haunma/fieldmill/hardware/fsorx/photodiode.jpg

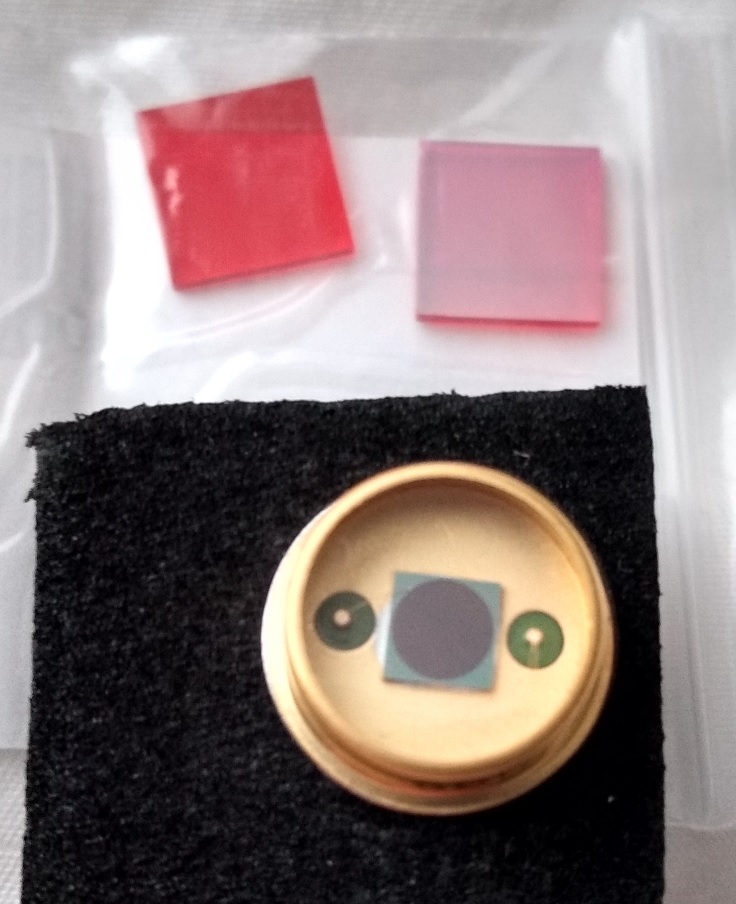
hardware/fsorx/photodiode.jpg
