haunma/fieldmill/hardware/fsorx/integrate_dump.png

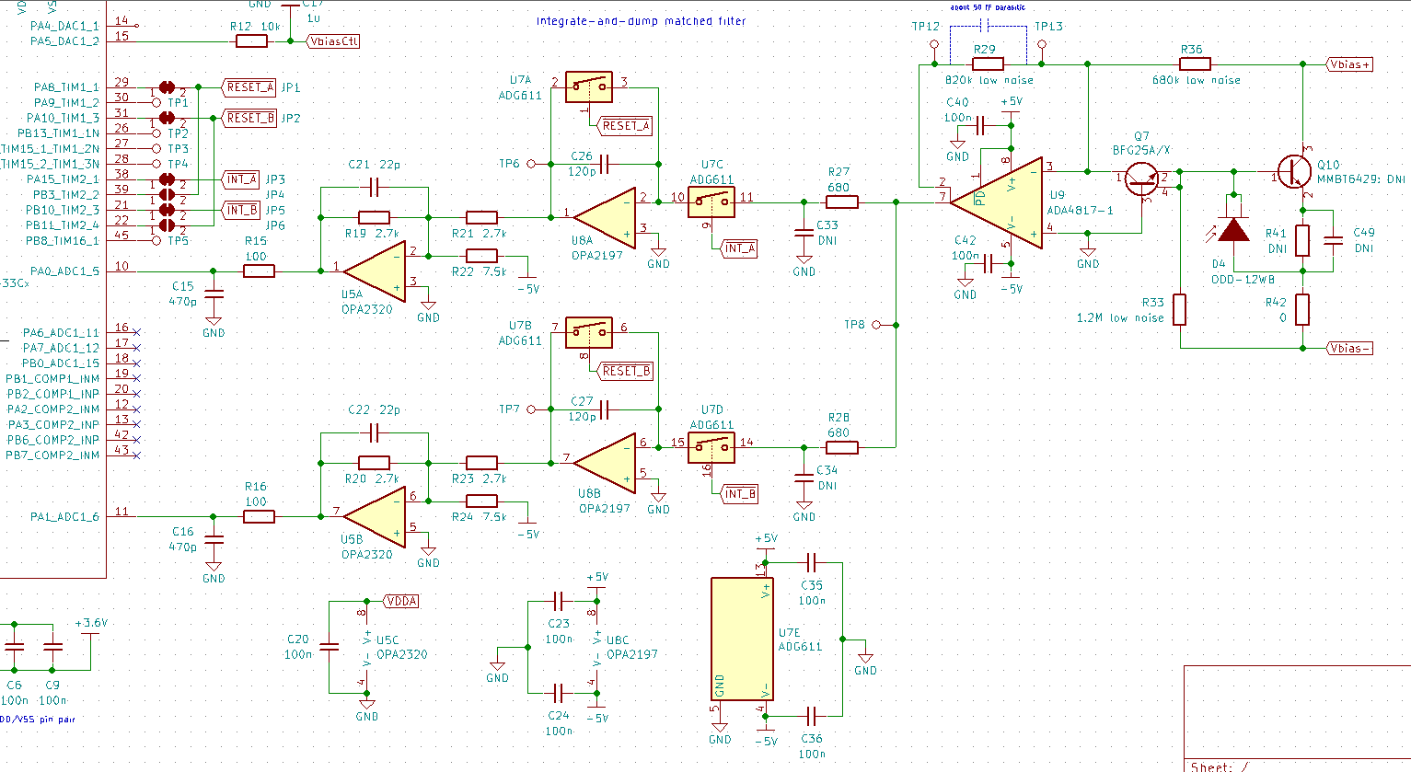
hardware/fsorx/integrate_dump.png
