haunma/fieldmill/hardware/fsorx/photodiode.png

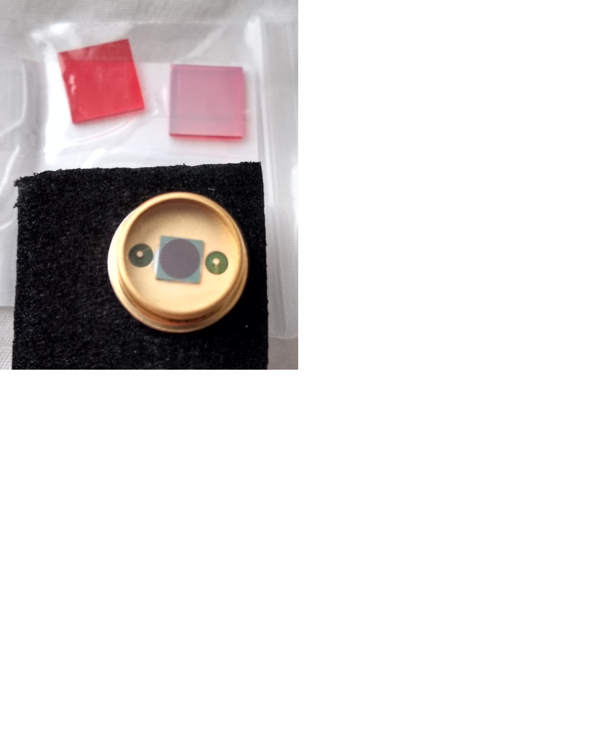
hardware/fsorx/photodiode.png
