haunma/fieldmill/hardware/fieldmill/fieldmill.pdf

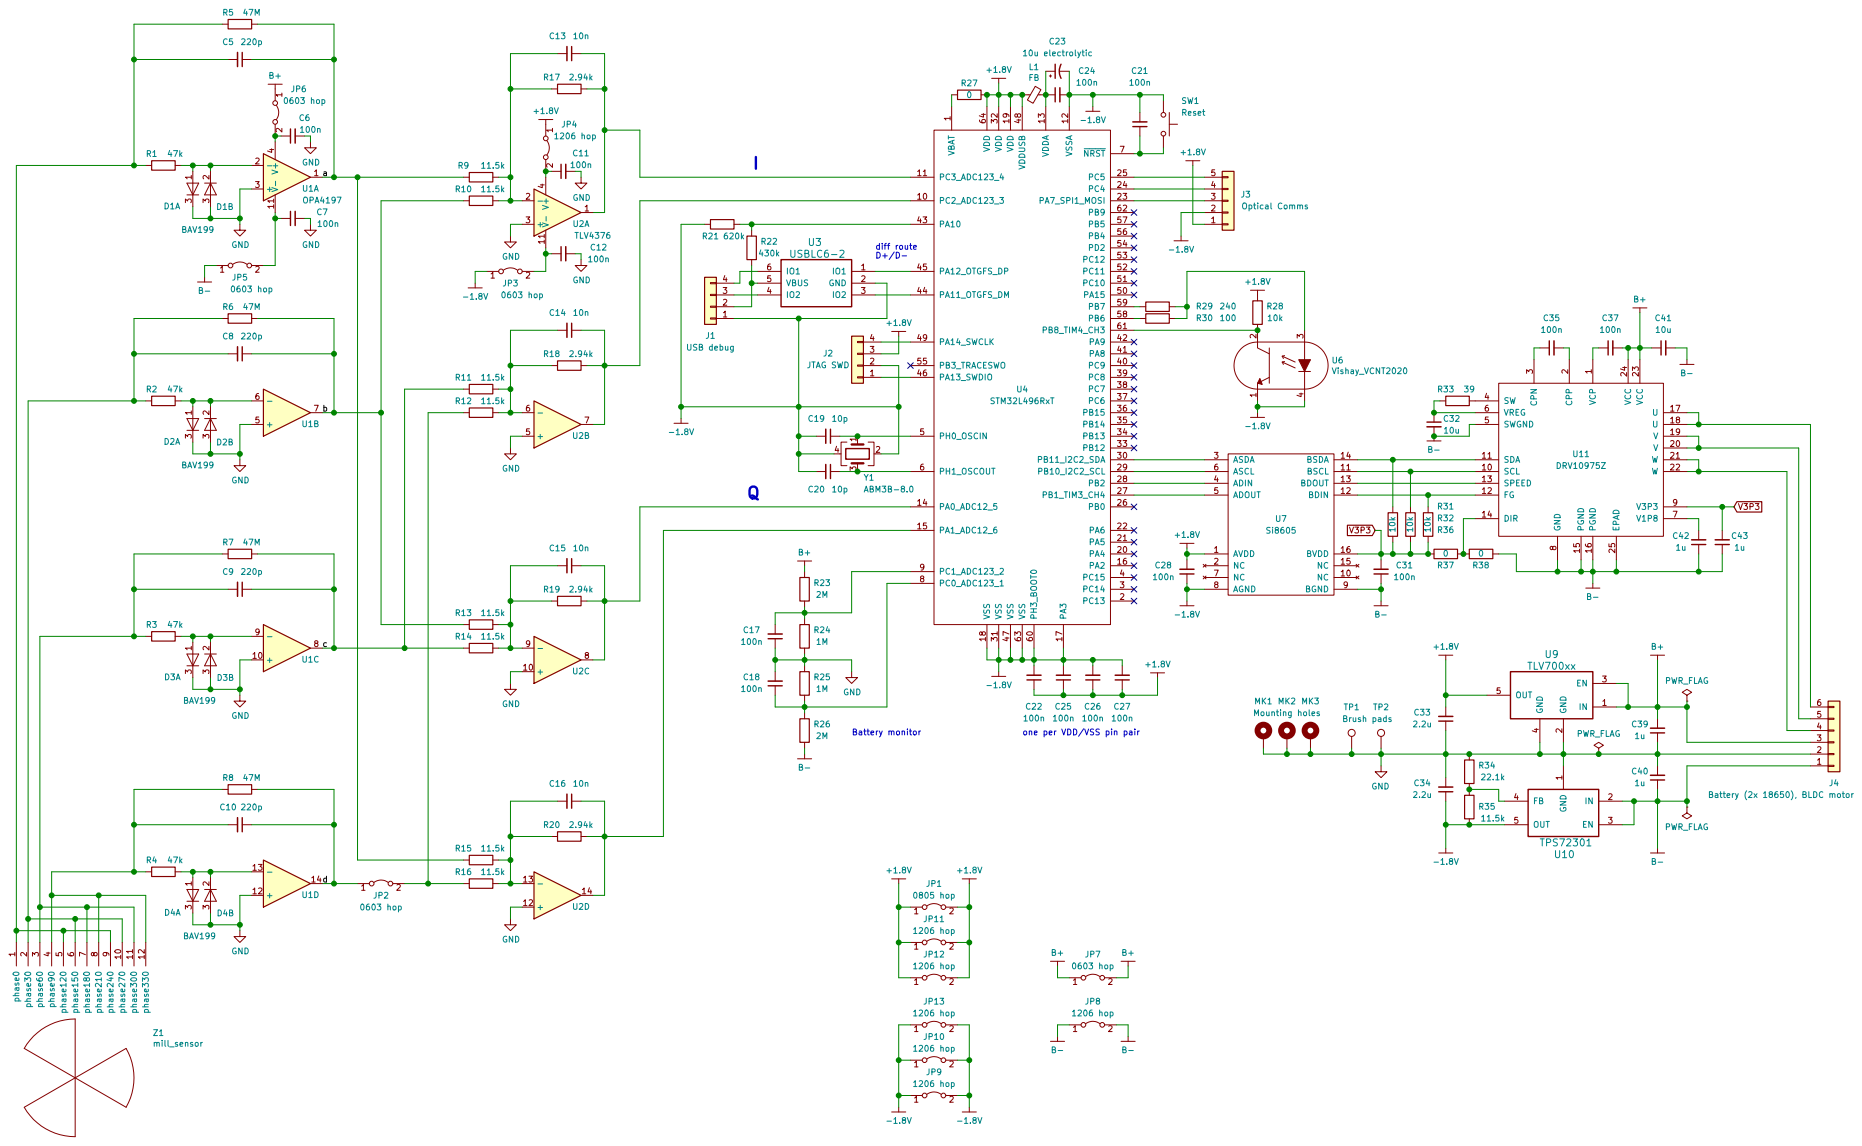
[picture p4: page 1]

1 PC2_ADC123_3 10 PC3_ADC123_4 11 VSSA 12 VDDA 13 PA0_ADC12_5 14 PA1_ADC12_6 15 PA2 16 PA3 17 VSS 18 VDD 19 PC13 2 PA4 20 PA5 21 PA6 22 PA7_SPI1_MOSI 23 PC4 24 PC5 25 PB0 26 PB1_TIM3_CH4 27 PB2 28 PB10_I2C2_SCL 29 PC14 3 PB11_I2C2_SDA 30 VSS 31 VDD 32 PB12 33 PB13 34 PB14 35 PB15 36 PC6 37 PC7 38 PC8 39 PC15 4 PC9 40 PA8 41 PA9 42 PA10 43 PA11_OTGFS_DM 44 PA12_OTGFS_DP 45 PA13_SWDIO 46 VSS 47 VDDUSB 48 PA14_SWCLK 49 PH0_OSCIN 5 PA15 50 PC10 51 PC11 52 PC12 53 PD2 54 PB3_TRACESWO 55 PB4 56 PB5 57 PB6 58 PB7 59 PH1_OSCOUT 6 PH3_BOOT0 60 PB8_TIM4_CH3 61 PB9 62 VSS 63 VDD 64 NRST 7 PC0_ADC123_1 8 PC1_ADC123_2 9 U4 STM32L496RxT

IO2 4 VBUS 5

22 VCC 23 VCC 24 EPAD 25 CPN

1 SCL 10 SDA 11 FG 12 SPEED 13 DIR 14 PGND 15 PGND 16 U
