haunma/fieldmill/hardware/fsorx/fsorx.pdf

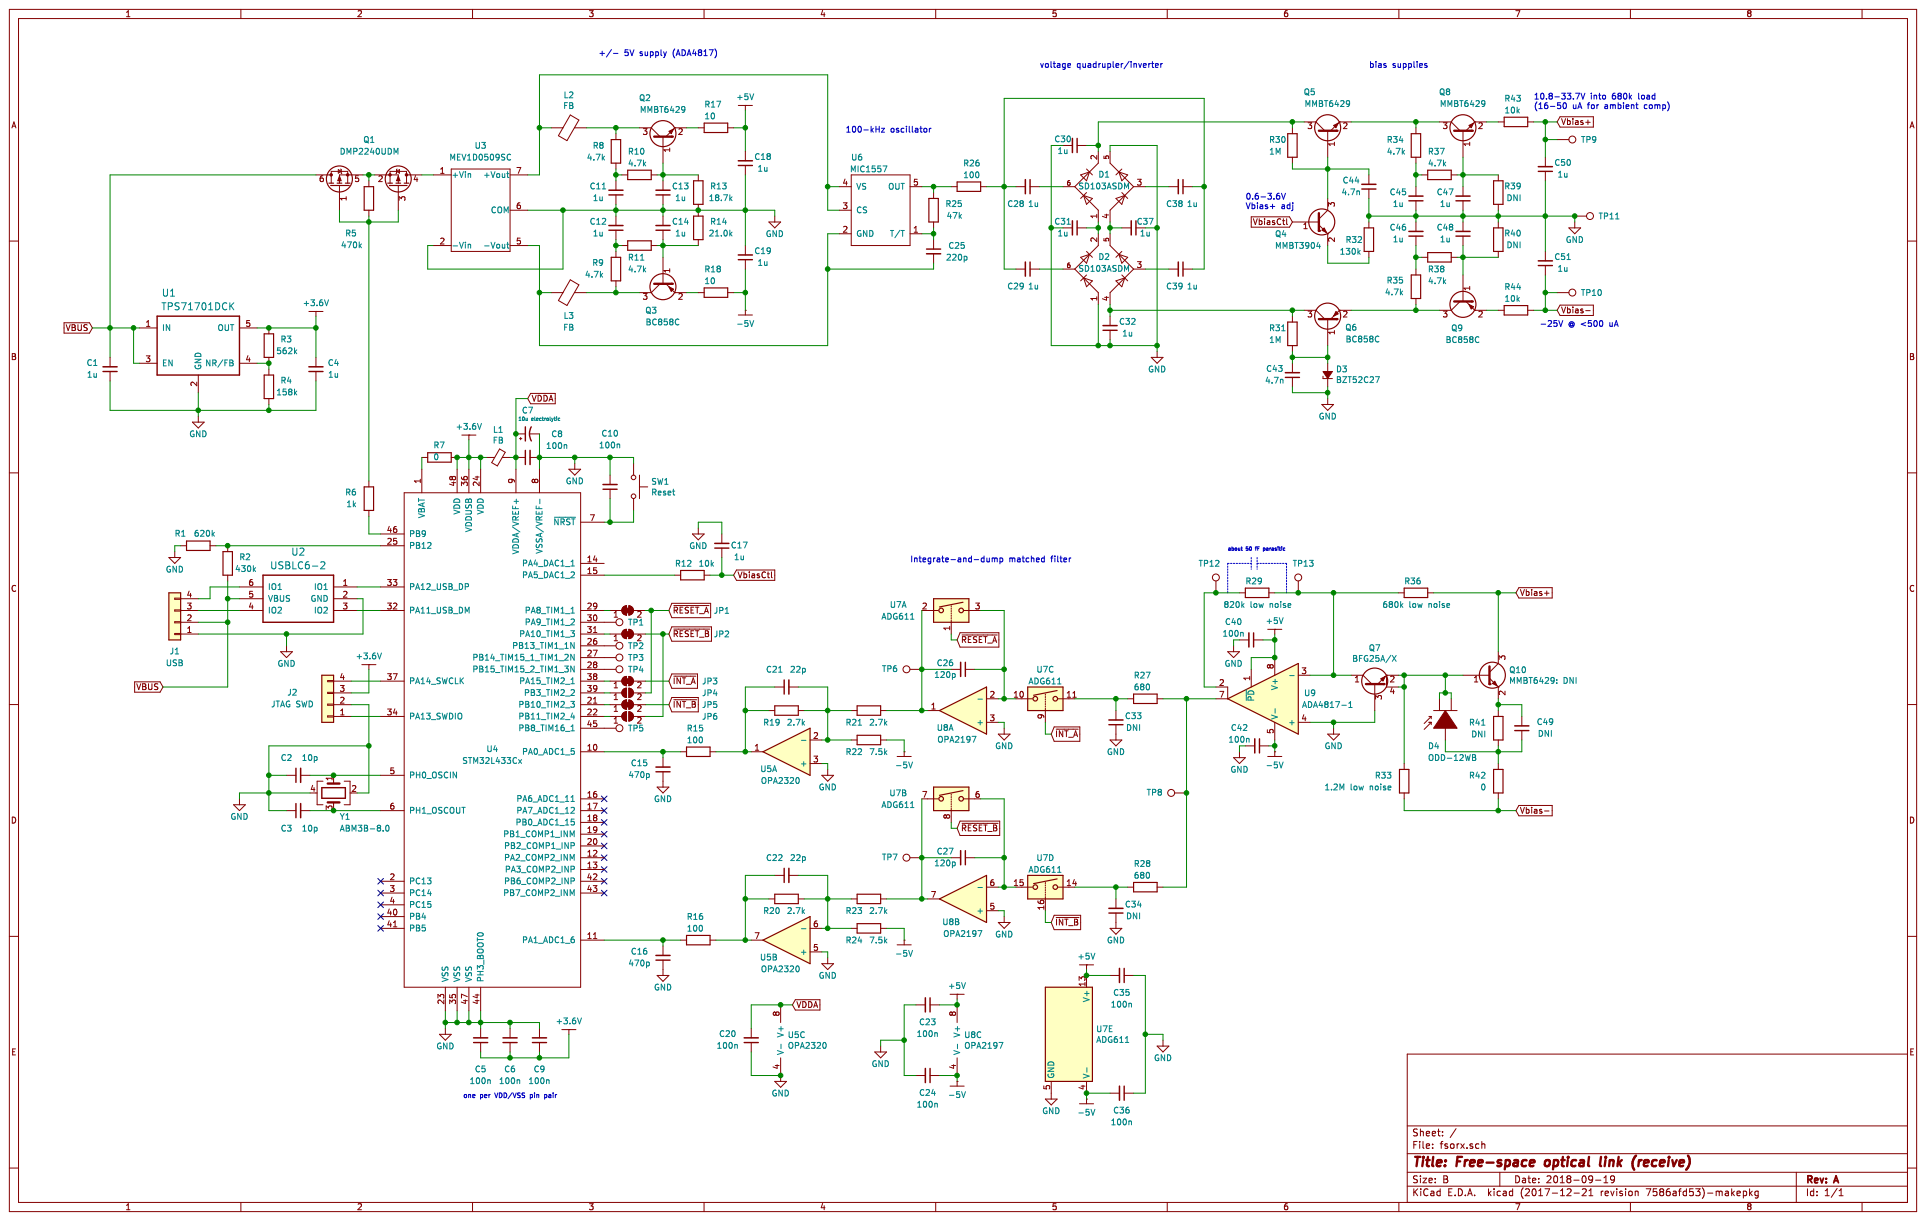
[picture p5: page 1]
