haunma/fieldmill/hardware/bias_gen.asc

C1: cap; 1µ; Rser=1 Lser=20n IC=16
C2: cap; 1µ; Rser=1 Lser=20n IC=32
C3: cap; 1µ; Rser=1 Lser=20n IC=-16
C4: cap; 1µ; Rser=1 Lser=20n IC=-32
C5: cap; 1µ; Rser=1 Lser=20n IC=-16
C6: cap; 1µ; Rser=1 Lser=20n IC=-32
C7: cap; 1µ; Rser=1 Lser=20n IC=16
C8: cap; 1µ; Rser=1 Lser=20n IC=32
C9: cap; 1µ; Rser=1 Lser=20n IC=10
C10: cap; 1µ; Rser=1
C11: cap; 1µ; Rser=1 IC=10
C12: cap; 4.7n; Rser=0.1 IC=10
C13: cap; 1µ; Rser=1 Lser=20n IC=10
C14: cap; 1µ; Rser=1 Lser=20n IC=-25
C15: cap; 1µ; Rser=1 Lser=20n IC=-25
C16: cap; 1µ; Rser=1 IC=-24
C17: cap; 4.7n; Rser=0.1 IC=-26
C18: cap; 1n; Rser=0.1 Lser=200p
C19: cap; 1n; Rser=0.1 Lser=200p
D1: schottky; BAT54
D2: schottky; BAT54
D3: schottky; BAT54
D4: schottky; BAT54
D5: schottky; BAT54
D6: schottky; BAT54
D7: schottky; BAT54
D8: schottky; BAT54
D9: zener; EDZV27B
L1: FerriteBead; 19µ; Ipk=3 Rser=0.6 Rpar=1130 Cpar=457f
L2: FerriteBead; 19µ; Ipk=3 Rser=0.6 Rpar=1130 Cpar=457f
L3: FerriteBead; 19µ; Ipk=3 Rser=0.6 Rpar=1130 Cpar=457f
L4: FerriteBead; 19µ; Ipk=3 Rser=0.6 Rpar=1130 Cpar=457f
Q1: npn; MMBT6429LT1
Q2: npn; 2N3904
Q3: npn; MMBT6429LT1
Q4: pnp; BC858C
Q5: pnp; BC858C
R2: res; 4.7k
R4: res; 4.7k
R5: res; 100k
R6: res; 10k
R7: res; 680k
R8: res; 1Meg
R9: res; 10k
R10: res; 4.7k
R11: res; 4.7k
R12: res; 10k
R13: res; 200k
R14: res; 1Meg
V1: voltage; PULSE(-9 9 0 10n 10n 7.5u 15u); Rser=15
V2: voltage; 3.5
Named nets: 0, Vp, Vn
.tran 0 400m 350m
