haunma/fieldmill/hardware/bias_gen_parasitics.asc

C1: cap; 1µ; Rser=1 Lser=20n
C2: cap; 1µ; Rser=1 Lser=20n
C3: cap; 1µ; Rser=1 Lser=20n
C4: cap; 1µ; Rser=1 Lser=20n
C5: cap; 1µ; Rser=1 Lser=20n
C6: cap; 1µ; Rser=1 Lser=20n
C7: cap; 1µ; Rser=1 Lser=20n
C8: cap; 1µ; Rser=1 Lser=20n
C9: cap; 1µ; Rser=1 Lser=20n
C10: cap; 1µ; Rser=1 Lser=20n
C11: cap; 1µ; Rser=1
C12: cap; 4.7n; Rser=0.1 Lser=10n
C13: cap; 1µ; Rser=1 Lser=20n
C14: cap; 1µ; Rser=1 Lser=20n
C15: cap; 1µ; Rser=1 Lser=20n
C16: cap; 1µ; Rser=1
C17: cap; 4.7n; Rser=0.1 Lser=10n
D1: schottky; BAT54
D2: schottky; BAT54
D3: schottky; BAT54
D4: schottky; BAT54
D5: schottky; BAT54
D6: schottky; BAT54
D7: schottky; BAT54
D8: schottky; BAT54
D9: zener; EDZV27B
L1: ind; 100µ
Q1: npn; MMBT6429LT1
Q2: npn; 2N3904
Q3: npn; MMBT6429LT1
Q4: pnp; BC858C
Q5: pnp; BC858C
R1: res; 220
R2: res; 4.7k
R4: res; 4.7k
R5: res; 130k
R6: res; 10k
R7: res; 680k
R8: res; 1Meg
R9: res; 10k
R10: res; 4.7k
R11: res; 4.7k
R12: res; 10k
R13: res; 200k
R14: res; 1Meg
V1: voltage; PULSE(-9 9 0 10n 10n 5u 10u)
V2: voltage; 0.6
Named nets: 0, Vp, Vn
.tran 0 300m 290m
