haunma/fieldmill/hardware/cmult.asc

C1: cap; 1µ
C2: cap; 1µ
C3: cap; 1µ
C4: cap; 1µ
C5: cap; 1µ
C6: cap; 1µ
I1: current; 22.3m
I2: current; 23.3m
L1: FerriteBead; 3.42µ; Ipk=0.2 Rser=0.6 Rpar=2780 Cpar=970f mfg="Würth Elektronik" pn="742 792 093"
L2: FerriteBead; 3.42µ; Ipk=0.2 Rser=0.6 Rpar=2780 Cpar=970f mfg="Würth Elektronik" pn="742 792 093"
Q1: npn; MMBT6429LT1
Q2: pnp; BC858C
R1: res; 4.7k
R2: res; 4.7k
R3: res; 10
R4: res; 4.7k
R5: res; 4.7k
R6: res; 10
R7: res; 200
R8: res; 200
R9: res; 18.7k
R10: res; 21.5k
V1: voltage; 9; AC 1; Rser=1
V2: voltage; 9; AC 1; Rser=1
Named nets: 0
.ac dec 1000 10 100Meg
