haunma/fieldmill/hardware/xtal_filt.asc

C1: cap; 2.3f
C2: cap; 0.85p
C3: cap; 0.25p
C4: cap; 0.25p
C5: cap; 0
I1: current; 0; AC 1n
L1: ind; 10.4k
Q1: npn; 2N2222
R1: res; 33k
R2: res; 100k
R3: res; 1Meg
R4: res; 100k
V1: voltage; 5
V2: voltage; 5
V3: voltage; 10
Named nets: Vp, Vm, 0
.ac lin 10000 32.4e3 32.7e3
;noise V(n001) I1 dec 1000 10 1e6
