haunma/fieldmill/hardware/xtal_osc.asc

A1: inv; td=10n Vhigh=3.3
C1: cap; 2.3f
C2: cap; 0.85p
C3: cap; 0.25p
C4: cap; 0.25p
C6: cap; 22p
C7: cap; 22p
L1: ind; 10.4k
R1: res; 33k
R5: res; 10Meg
R6: res; 300k
Named nets: 0
.tran 2m
