haunma/fieldmill/hardware/fsorx/gated_int.asc

B1: bv; V=(100u +200u*white(8e6*time))
C1: cap; 120p
C2: cap; 68p
C3: cap; 10p
C4: cap; 470p
R1: res; 680
R2: res; 0
R3: res; 0
R4: res; 2.94k
R5: res; 8.2k
R6: res; 2.94k
R7: res; 100
S1: sw; SW1
S2: sw; SW2
U1: AD8034
U2: ADA4891
V1: voltage; PULSE(1 0 0 1n 1n 1u 2u)
V2: voltage; PULSE(1 0 0.95u 1n 1n 1.7u 2u)
V3: voltage; 5
V4: voltage; 5
V5: voltage; 3.6
Named nets: 0, int, reset, out, Vp, Vm, Va, adc
.lib opamp.sub
.model SW1 SW(Ron=60 Roff=100Meg Vt=.5 Vh=-.4)
.model SW2 SW(Ron=60 Roff=100Meg Vt=.5 Vh=-.4)
.tran 50u
