haunma/fieldmill/hardware/fsorx/fsorx.kicad_pcb

## KiCad design hardware/fsorx/fsorx.kicad_pcb (2019-08-28)

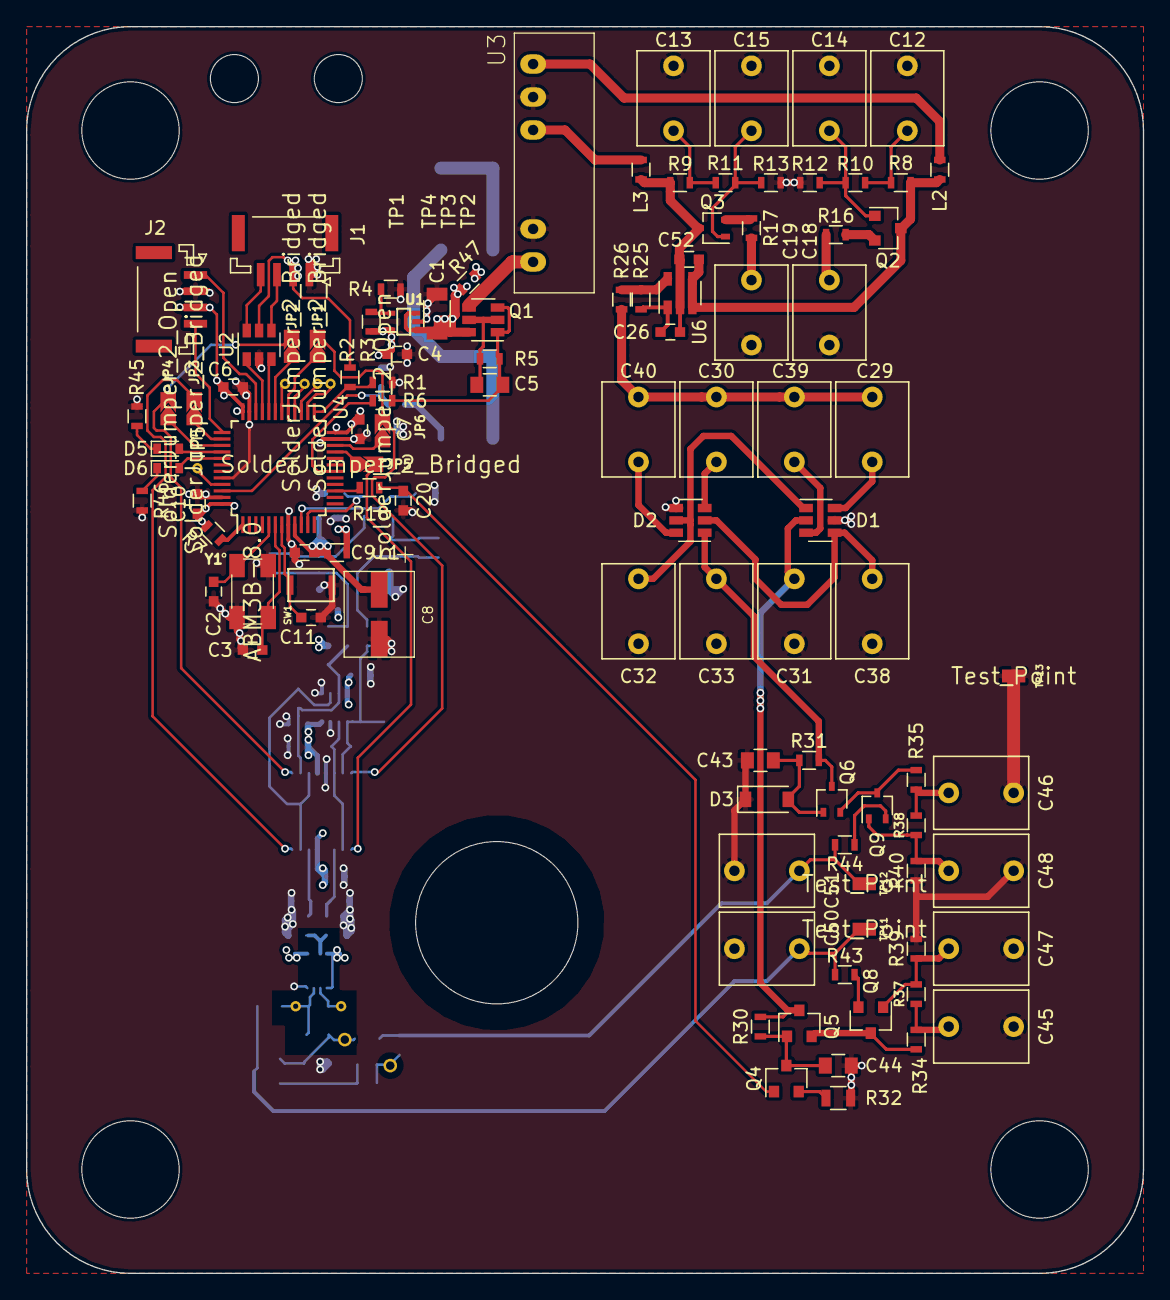
[picture p6: board fsorx.kicad_pcb from above]

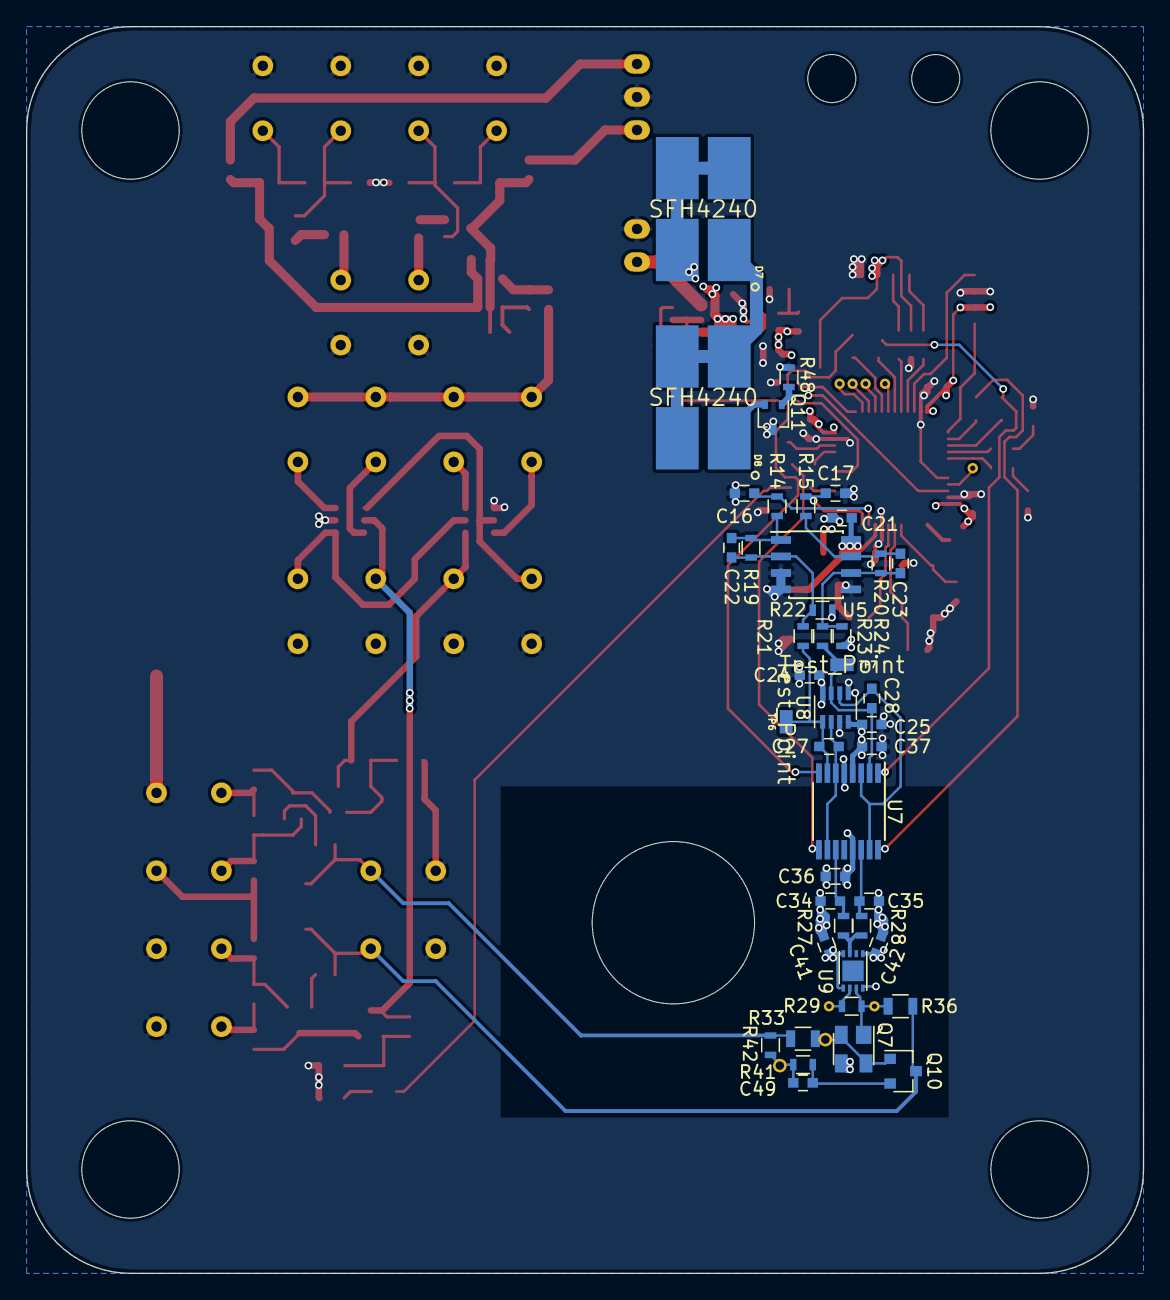
[picture p7: board fsorx.kicad_pcb from below]

Board: 4 copper layers, 86.0 x 96.0 mm, 161 parts (46 on the bottom side), 99 nets.

Parts:
C1: 10u; C_1206
C2, C3, C22, C23: 10p; C_0603
C4, C20: 1u; C_0603
C5: 1u; C_0805
C6, C7, C9, C10, C11, C21, C24, C25, C36, C37, C41, C42, C52: 100n; C_0603
C8: 10u electrolytic; Panasonic_ECEV1CA220P
C12, C13, C14, C15, C18, C19, C29, C30, C31, C32, C33, C38, C39, C40, C45, C46, C47, C48, C50, C51: 1u; C_Rect_L7.2mm_W5.5mm_P5.00mm_FKS2_FKP2_MKS2_MKP2
C16, C17: 470p; C_0603
C26: 220p; C_0603
C27, C28: 120p; C_0603
C34, C35: 68p; C_0603
C43, C44: 4.7n; C_0805
C49: DNI; C_0603
D1, D2: SD103ASDM; SOT-23-6
D3: BZT52C27; D_SOD-123
D5: SAT; D_0603
D6: LOCK; D_0603
D7, D8: SFH4240; OSRAM_SFH4240
J1: USB; JST_GH_SM04B-GHS-TB_04x1.25mm_Angled
J2: JTAG SWD; JST_GH_SM04B-GHS-TB_04x1.25mm_Angled
JP1, JP2, JP3, JP5: SolderJumper_2_Bridged; Solder_Bridge
JP4, JP6: SolderJumper_2_Open; Solder_Bridge
L1, L2, L3: FB; R_0603
MK1, MK2, MK3, MK4: Suction cup; MountingHole_7.5mm
MK5: Photodiode; MountingHole_TO8
MK6, MK7: USB strain relief; MountingHole_3.7mm
Q1: DMP2240UDM; SOT-23-6
Q2, Q5, Q8: MMBT6429; SOT-23
Q3, Q6, Q9: BC858C; SOT-323_SC-70
Q4: MMBT3904; SOT-23
Q7: BFG25A/X; SOT-143
Q10: MMBT6429: DNI; SOT-23
Q11: BSS214NW; SOT-323_SC-70
R1: 620k; R_0603
R2: 430k; R_0603
R3: 562k; R_0603
R4: 158k; R_0603
R5: 470k; R_0603
R6, R25: 47k; R_0603
R7, R42: 0; R_0603
R8, R9, R10, R11, R34, R35, R37, R38: 4.7k; R_0603
R12: 18.7k; R_0603
R13: 21.5k; R_0603
R14, R15, R26: 100; R_0603
R16, R17, R47: 10; R_0603
R18, R43, R44: 10k; R_0603
R19, R20, R21, R23: 2.94k; R_0603
R22, R24: 8.2k; R_0603
R27, R28: 680; R_0603
R29: 820k low noise; R_0603
R30, R31: 1M; R_0603
R32: 130k; R_0805
R33: 1.2M low noise; R_0805
R36: 680k low noise; R_0805
R39, R40, R41: DNI; R_0603
R45, R46: TBD; R_0603
R48: 100k; R_0603
SW1: Reset; CK_KXT3_switch
TP: Test_Point; SolderWirePad_single_0-65mmDrill
TP1, TP2, TP3, TP4, TP5, TP9, TP10: Test_Point; SolderWirePad_single_0-4mmDrill
TP6, TP7, TP11, TP12, TP13: Test_Point; KOA_Speer_RCU_testpad
TP#2: Test_Point; SolderWirePad_single_0-65mmDrill
U1: TPS71701DCK; SC70-5
U2: USBLC6-2; SOT-23-6
U3: MEV1D0509SC; Murata_MEV1DxxxxSC
U4: STM32L433Cx; LQFP-48_7x7mm_Pitch0.5mm
U5: ADA4891-2; SOIC-8_3.9x4.9mm_Pitch1.27mm
U6: MIC1557; SOT-23-5
U7: ADG611; TSSOP-16_4.4x5mm_Pitch0.65mm
U8: AD8034; SOT-23-8
U9: ADA4817-1; LFCSP-8-1EP_2x3mm_Pitch0.5mm
Y1: ABM3B-8.0; Abracon_ABM3B

Connections:
+3.6V: C4.2, C6.1, C7.1, C10.1, J2.3, L1.2, R3.2, R7.2, U1.5, U4.24, U4.36, U4.48
+5V: C18.2, C24.1, C36.2, C41.1, R16.1, U7.13, U8.8, U9.1, U9.8
-5V: C19.1, C25.1, C37.2, C42.1, R17.1, R22.1, R24.1, U7.4, U8.4, U9.5
GND: C1.1, C2.1, C3.1, C4.1, C6.2, C7.2, C8.2, C9.2, C10.2, C11.2, C12.1, C13.2, C14.1, C15.2, C16.1, C17.1, C18.1, C19.2, C20.1, C21.1, C24.2, C25.2, C31.2, C32.2, C33.1, C34.1, C35.1, C36.1, C37.1, C38.1, C41.2, C42.2, C43.1, C44.1, C45.1, C46.2, C47.1, C48.2, C50.1, C51.2, D1.5, D2.4, D3.1, J1.1, J2.2, Q7.3, Q11.3, R1.1, R4.1, R12.1, R13.2, R32.1, R39.1, R40.2, R45.1, R46.1, R48.2, SW1.1, TP13.1, U1.2, U2.2, U3.2, U3.6, U4.8, U4.23, U4.35, U4.44, U4.47, U5.3, U5.4, U5.5, U7.5, U8.3, U8.5, U9.4, Y1.2, Y1.4
unnamed: C2.2, U4.5, Y1.1
unnamed: C3.2, U4.6, Y1.3
unnamed: C5.1, Q1.1, Q1.3, R5.1, R6.2
unnamed: C5.2, Q1.2, Q1.5, R5.2
unnamed: C11.1, SW1.2, U4.7
unnamed: C12.2, R8.2, R10.2
unnamed: C13.1, R9.2, R11.2
unnamed: C14.2, Q2.1, R10.1, R12.2
unnamed: C15.1, Q3.1, R11.1, R13.1
unnamed: C16.2, R14.2, U4.10
unnamed: C17.2, R15.2, U4.11
unnamed: C22.1, R14.1, R19.2, U5.1
unnamed: C22.2, R19.1, R21.2, R22.2, U5.2
unnamed: C23.1, R15.1, R20.2, U5.7
unnamed: C23.2, R20.1, R23.2, R24.2, U5.6
unnamed: C26.1, R25.1, U6.1
unnamed: C26.2, C52.1, L3.2, Q3.3, R9.1, U6.2
unnamed: C27.1, U7.6, U7.10, U8.2
unnamed: C27.2, R21.1, TP6.1, U7.7, U8.1
unnamed: C28.1, U7.3, U7.15, U8.6
unnamed: C28.2, R23.1, TP7.1, U7.2, U8.7
unnamed: C29.1, D1.6
unnamed: C29.2, C30.2, C39.1, C40.1, R26.1
unnamed: C30.1, D2.3
unnamed: C31.1, D1.2, Q5.3, R30.1
unnamed: C32.1, D1.1, D2.5
unnamed: C33.2, D2.1, Q6.3, R31.1
unnamed: C34.2, R27.2, U7.11
unnamed: C35.2, R28.2, U7.14
unnamed: C38.2, D1.4, D2.2
unnamed: C39.2, D1.3
unnamed: C40.2, D2.6
unnamed: C43.2, D3.2, Q6.1, R31.2
unnamed: C44.2, Q4.3, Q5.1, R30.2
unnamed: C45.2, R34.2, R37.2
unnamed: C46.1, R35.2, R38.2
unnamed: C47.2, Q8.1, R37.1, R39.2
unnamed: C48.1, Q9.1, R38.1, R40.1
unnamed: C49.1, R41.2, R42.1, TP.1
unnamed: C49.2, Q10.2, R41.1
unnamed: C52.2, L2.2, Q2.3, R8.1, U6.3, U6.4
unnamed: Q7.2, Q7.4, Q10.1, R33.1, TP#2.1
unnamed: D5.1, R45.2
unnamed: D5.2, U4.40
unnamed: D6.1, R46.2
unnamed: D6.2, U4.41
unnamed: D7.1, D8.2, D8.3, D8.4
unnamed: D7.2, D7.3, D7.4, R47.1
unnamed: D8.1, Q11.2
unnamed: J1.3, U2.4
unnamed: J1.4, U2.6
unnamed: J2.1, U4.34
unnamed: J2.4, U4.37
unnamed: JP1.1, U4.29
unnamed: JP2.1, U4.31
unnamed: JP3.1, U4.38
unnamed: JP4.1, U4.39
unnamed: JP5.1, U4.21
unnamed: JP6.1, U4.22
unnamed: L2.1, U3.7
unnamed: L3.1, U3.5
unnamed: Q1.4, U3.1
unnamed: Q2.2, R16.2
unnamed: Q3.2, R17.2
unnamed: Q4.2, R32.2
unnamed: Q5.2, Q8.3, R34.1
unnamed: Q6.2, Q9.3, R35.1
unnamed: Q7.1, R29.2, R36.1, TP10.1, U9.3
unnamed: Q8.2, R43.2
unnamed: Q9.2, R44.2
unnamed: Q11.1, R48.1, U4.46
unnamed: R1.2, R2.2, U4.25
unnamed: R3.1, R4.2, U1.4
unnamed: R6.1, U4.18
unnamed: R7.1, U4.1
unnamed: R18.2, U4.15
unnamed: R25.2, R26.2, U6.5
unnamed: R27.1, R28.1, U9.7
unnamed: R29.1, TP9.1, U9.2
unnamed: TP1.1, U4.30
unnamed: TP2.1, U4.26
unnamed: TP3.1, U4.27
unnamed: TP4.1, U4.28
unnamed: TP5.1, U4.45
unnamed: U2.1, U4.33
unnamed: U2.3, U4.32
VBUS: C1.2, J1.2, Q1.6, R2.1, R47.2, U1.1, U1.3, U2.5
VDDA: C8.1, C9.1, C21.2, L1.1, U4.9, U5.8
Vbias+: C50.2, Q10.3, R36.2, R43.1, TP11.1
Vbias-: C51.1, R33.2, R42.2, R44.1, TP12.1
VbiasCtl: C20.2, Q4.1, R18.1
~INT_A: JP5.2, U7.9
~INT_B: JP3.2, U7.16
~RESET_A: JP1.2, JP6.2, U7.8
~RESET_B: JP2.2, JP4.2, U7.1
