haunma/fieldmill/hardware/fieldmill/fieldmill.kicad_pcb

## KiCad design hardware/fieldmill/fieldmill.kicad_pcb (2019-08-28)

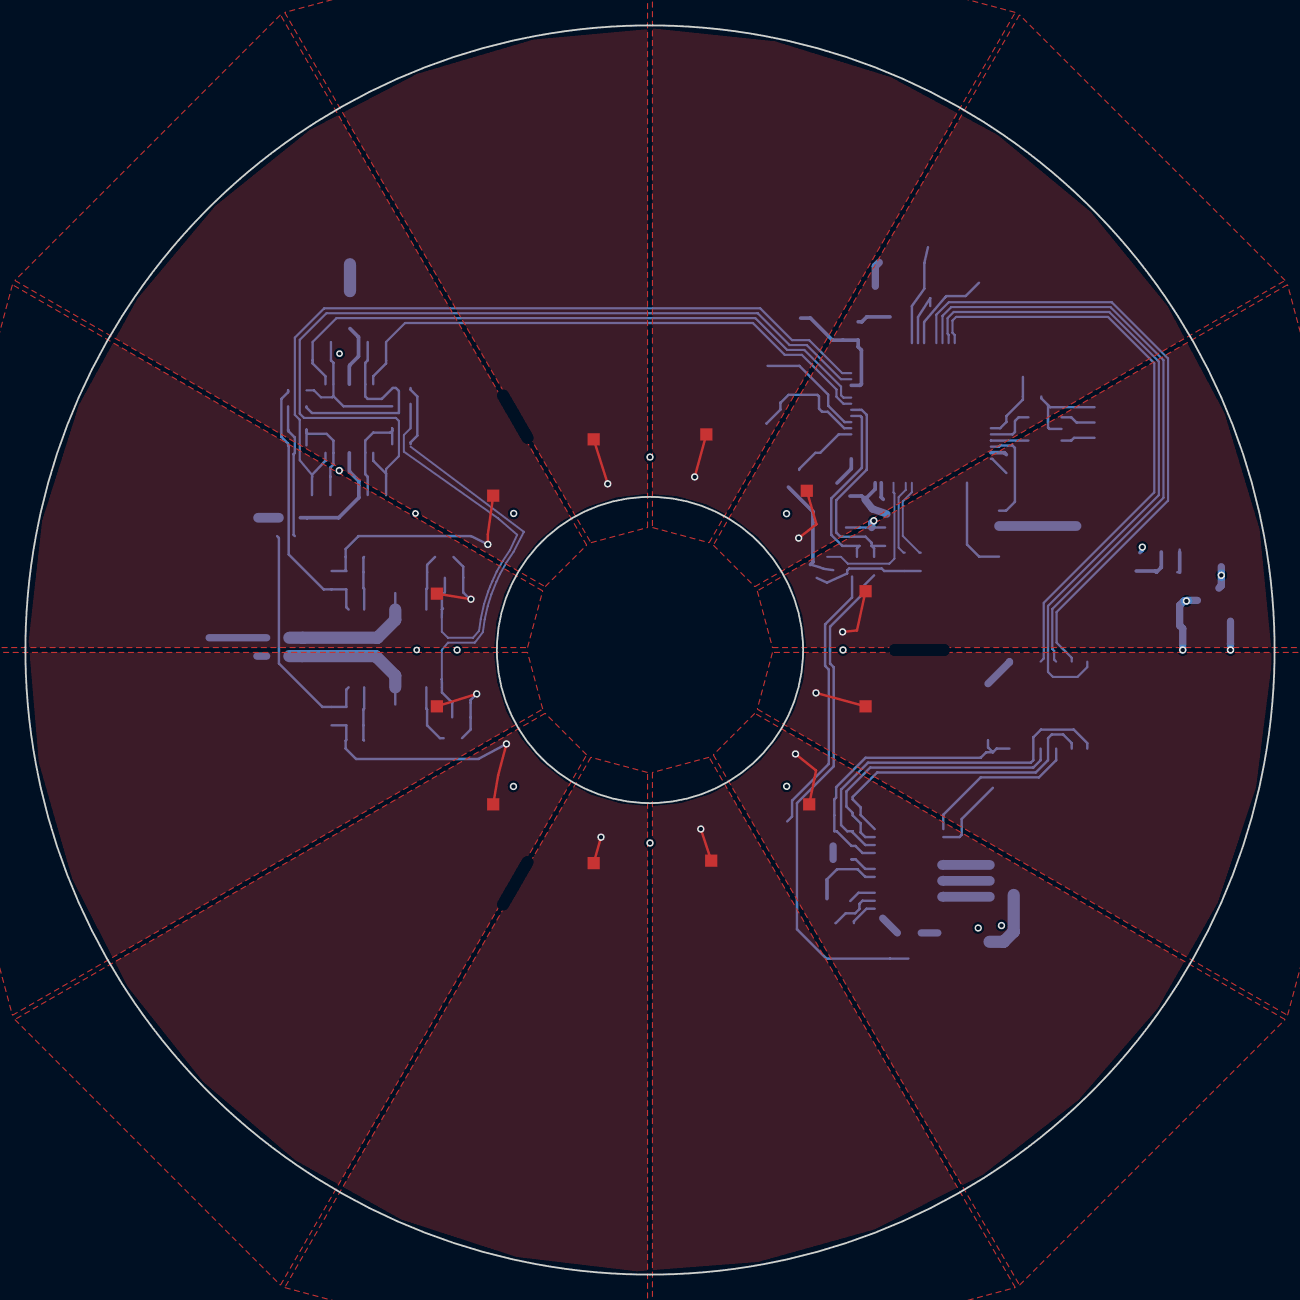
[picture p8: board fieldmill.kicad_pcb from above]

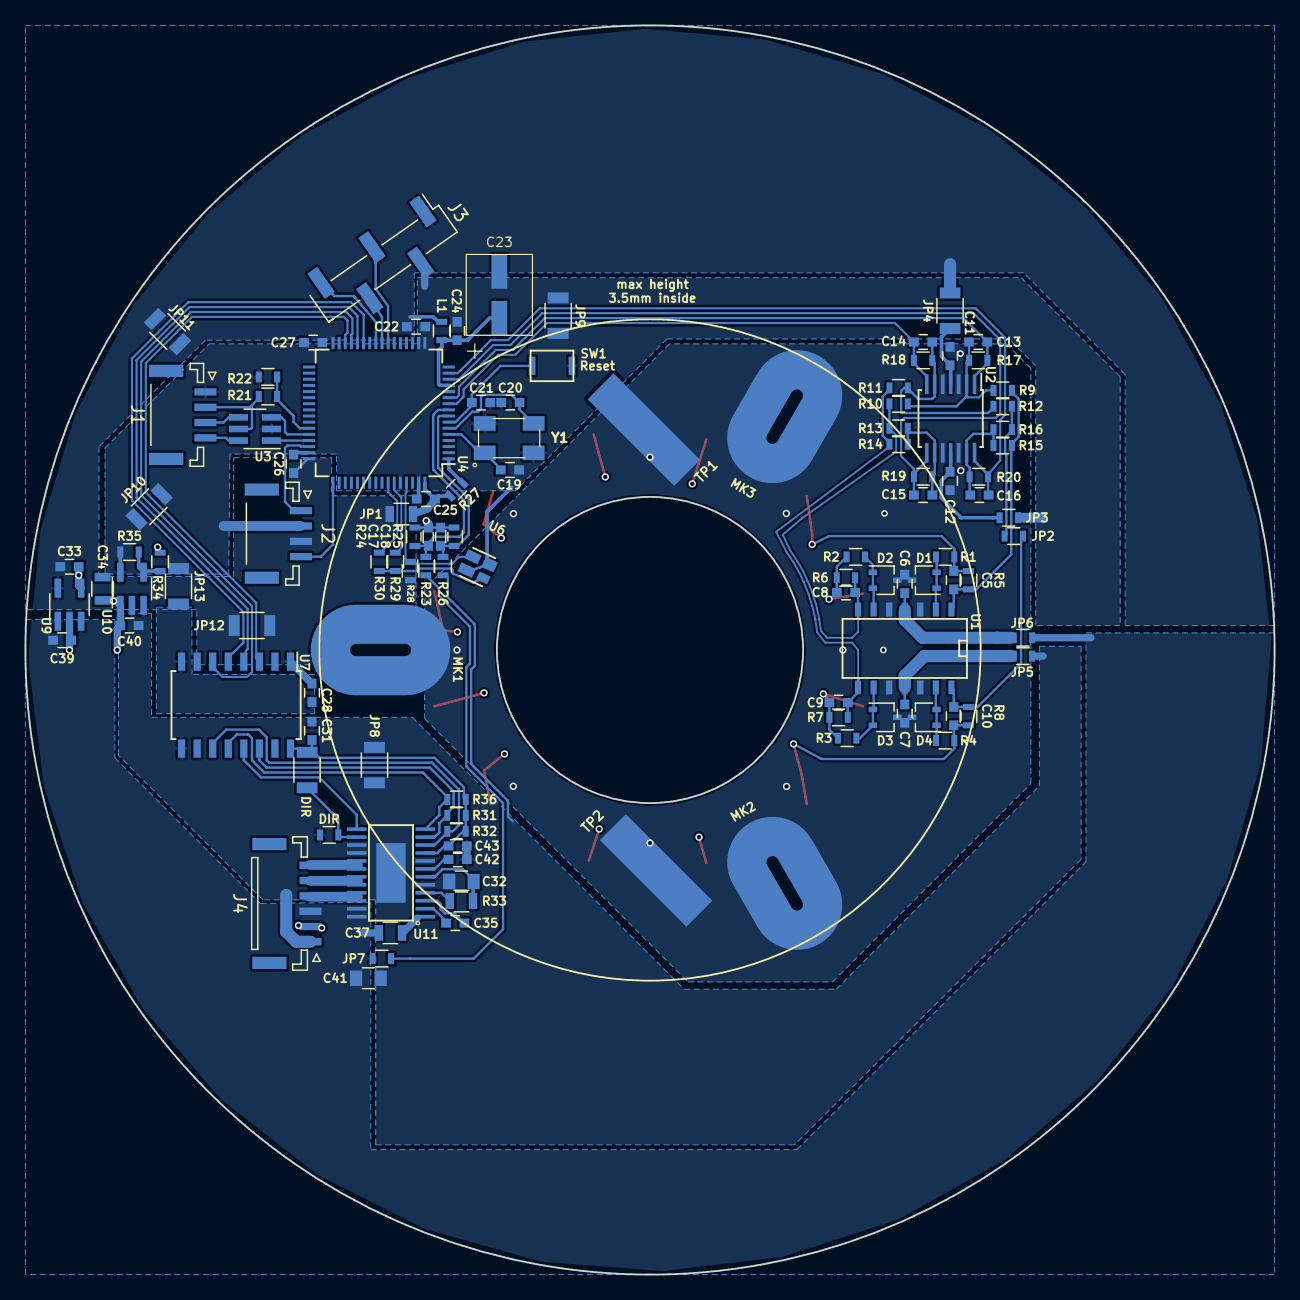
[picture p9: board fieldmill.kicad_pcb from below]

Board: 4 copper layers, 102.0 x 102.0 mm, 112 parts (111 on the bottom side), 72 nets.

Parts:
C5, C8, C9, C10: 220p; C_0603
C6, C7, C11, C12, C17, C18, C21, C22, C24, C25, C26, C27, C28, C31, C35: 100n; C_0603
C13, C14, C15, C16: 10n; C_0603
C19, C20: 10p; C_0603
C23: 10u electrolytic; Panasonic_ECEV1CA220P
C32, C41: 10u; C_0805
C33: 2.2u; C_0603
C34: 2.2u; R_0805
C37: 100n; R_0805
C39, C40, C42, C43: 1u; C_0603
D1, D2, D3, D4: BAV199; SOT-323_SC-70
J1: USB debug; JST_GH_SM04B-GHS-TB_04x1.25mm_Angled
J2: JTAG SWD; JST_GH_SM04B-GHS-TB_04x1.25mm_Angled
J3: Optical Comms; Pin_Header_Straight_1x05_Pitch2.54mm_SMD_Pin1Left
J4: Battery (2x 18650), BLDC motor; JST_GH_BM06B-GHS-TBT_06x1.25mm_Straight
JP1: 0805 hop; R_0805
JP2, JP3, JP5, JP6, JP7: 0603 hop; R_0603
JP4, JP8, JP9, JP10, JP11, JP12, JP13: 1206 hop; R_1206
L1: FB; R_0603
MK1, MK2, MK3: Mounting holes; Wurth_9771050360R
R1, R2, R3, R4: 47k; R_0603
R5, R6, R7, R8: 47M; R_0603
R9, R10, R11, R12, R13, R14, R15, R16: 12k; R_0603
R17, R18, R19, R20: 3k; R_0603
R21: 620k; R_0603
R22: 430k; R_0603
R23, R26: 2M; R_0603
R24, R25: 1M; R_0603
R27, R38: 0; R_0603
R28, R31, R32, R36: 10k; R_0603
R29: 330; R_0603
R30: 180; R_0603
R33: 39; R_0805
R34: 22.1k; R_0603
R35: 11.5k; R_0603
R37: 0; R_1206
SW1: Reset; CK_KXT3_switch
TP1: Brush pads; brush_pad
TP2: Brush pad; brush_pad
U1: OPA4197; SOIC-14_N
U2: TLV4376; TSSOP14
U3: USBLC6-2; SOT-23-6_Handsoldering
U4: STM32L496RxT; LQFP-64_10x10mm_Pitch0.5mm
U6: Vishay_VCNT2020
U7: Si8605; SOIC-16W_5.3x10.2mm_Pitch1.27mm
U9: TLV700xx; SOT-23-5_HandSoldering
U10: TPS72301; SOT-23-5_HandSoldering
U11: DRV10975Z; TSSOP24_EP
Y1: ABM3B-8.0; Abracon_ABM3B
Z1: mill_sensor

Connections:
+1.8V: C22.1, C25.1, C26.1, C27.1, C28.2, C33.2, J2.3, J3.1, JP1.1, JP1.2, JP4.1, JP11.1, JP11.2, JP12.1, JP12.2, L1.2, R27.1, R28.2, U4.19, U4.32, U4.48, U4.64, U7.1, U9.5
-1.8V: C19.2, C20.2, C21.2, C22.2, C23.2, C24.2, C25.2, C26.2, C27.2, C28.1, C34.1, J1.1, J2.2, J3.2, JP3.1, JP9.1, JP9.2, JP10.1, JP10.2, JP13.1, JP13.2, R21.2, R35.1, SW1.1, U3.2, U4.12, U4.17, U4.18, U4.31, U4.47, U4.60, U4.63, U6.1, U6.4, U7.8, U10.5, Y1.2, Y1.4
/a: C5.1, R5.1, R9.2, R15.2, U1.1
/b: C8.1, R6.1, R10.2, R13.2, U1.7
/c: C9.1, R7.1, R11.2, R14.2, U1.8
/d: C10.1, JP2.1, R8.1, U1.14
B+: C37.2, C39.2, C41.1, J4.3, JP6.1, JP7.1, JP7.2, R23.2, U9.1, U9.3, U11.23, U11.24
B-: C31.1, C32.2, C40.1, C41.2, C42.1, C43.1, J4.1, JP5.1, JP8.1, JP8.2, R26.1, R38.2, U7.9, U10.2, U10.3, U11.5, U11.8, U11.15, U11.16, U11.25
GND: C6.2, C7.2, C11.2, C12.2, C17.1, C18.2, C33.1, C34.2, C39.1, C40.2, D1.3, D2.3, D3.3, D4.3, J4.2, MK1.1, MK2.1, MK3.1, R24.1, R25.2, R34.2, TP1.1, TP2.1, U1.3, U1.5, U1.10, U1.12, U2.3, U2.5, U2.10, U2.12, U9.2, U9.4, U10.1
unnamed: C5.2, R1.2, R5.2, Z1.1, Z1.5, Z1.9
unnamed: C6.1, JP6.2, U1.4
unnamed: C7.1, JP5.2, U1.11
unnamed: C8.2, R2.2, R6.2, Z1.2, Z1.6, Z1.10
unnamed: C9.2, R3.2, R7.2, Z1.3, Z1.7, Z1.11
unnamed: C10.2, R4.2, R8.2, Z1.4, Z1.8, Z1.12
unnamed: C11.1, JP4.2, U2.4
unnamed: C12.1, JP3.2, U2.11
unnamed: C13.1, R17.1, U2.1, U4.11
unnamed: C13.2, R9.1, R10.1, R17.2, U2.2
unnamed: C14.1, R18.1, U2.7, U4.10
unnamed: C14.2, R11.1, R12.1, R18.2, U2.6
unnamed: C15.1, R19.1, U2.8, U4.14
unnamed: C15.2, R13.1, R14.1, R19.2, U2.9
unnamed: C16.1, R20.1, U2.14, U4.15
unnamed: C16.2, R15.1, R16.1, R20.2, U2.13
unnamed: C17.2, R23.1, R24.2, U4.9
unnamed: C18.1, R25.1, R26.2, U4.8
unnamed: C19.1, U4.5, Y1.1
unnamed: C20.1, U4.6, Y1.3
unnamed: C21.1, SW1.2, U4.7
unnamed: C23.1, C24.1, L1.1, U4.13
unnamed: C32.1, R33.2, U11.6
unnamed: C35.1, U11.3
unnamed: C35.2, U11.2
unnamed: C37.1, U11.1
unnamed: C42.2, U11.7
unnamed: D1.1, D1.2, R1.1, U1.2
unnamed: D2.1, D2.2, R2.1, U1.6
unnamed: D3.1, D3.2, R3.1, U1.9
unnamed: D4.1, D4.2, R4.1, U1.13
unnamed: J1.2, R22.1, U3.5
unnamed: J1.3, U3.4
unnamed: J1.4, U3.6
unnamed: J2.1, U4.46
unnamed: J2.4, U4.49
unnamed: J3.3, U4.23
unnamed: J3.4, U4.24
unnamed: J3.5, U4.25
unnamed: J4.4, U11.21, U11.22
unnamed: J4.5, U11.19, U11.20
unnamed: J4.6, U11.17, U11.18
unnamed: JP2.2, R12.2, R16.2
unnamed: R21.1, R22.2, U4.43
unnamed: R27.2, U4.1
unnamed: R28.1, U4.61, U6.2
unnamed: R29.1, U4.59
unnamed: R29.2, R30.2, U6.3
unnamed: R30.1, U4.58
unnamed: R31.2, U7.14, U11.11
unnamed: R32.2, U7.11, U11.10
unnamed: R33.1, U11.4
unnamed: R34.1, R35.2, U10.4
unnamed: R36.2, U7.12, U11.12
unnamed: R37.2, R38.1, U11.14
unnamed: U3.1, U4.45
unnamed: U3.3, U4.44
unnamed: U4.27, U7.5
unnamed: U4.28, U7.4
unnamed: U4.29, U7.6
unnamed: U4.30, U7.3
unnamed: U7.13, U11.13
V3P3: C31.2, C43.2, R31.1, R32.1, R36.1, R37.1, U7.16, U11.9
